cyberangel4869/PortableBlueToothKeyBoard/README.md

# PortableBlueToothKeyBoard
基于ESP32S3的9键蓝牙键盘，有蓝牙和有线两种模式，可以从C口直接编程和供电，带有自动休眠功能，一段时间内无人使用就自动降低中断处理频率或进入休眠模式以节省电量。

立创开源硬件平台地址：

https://oshwhub.com/elecangel/project_krufaupn

## 外观
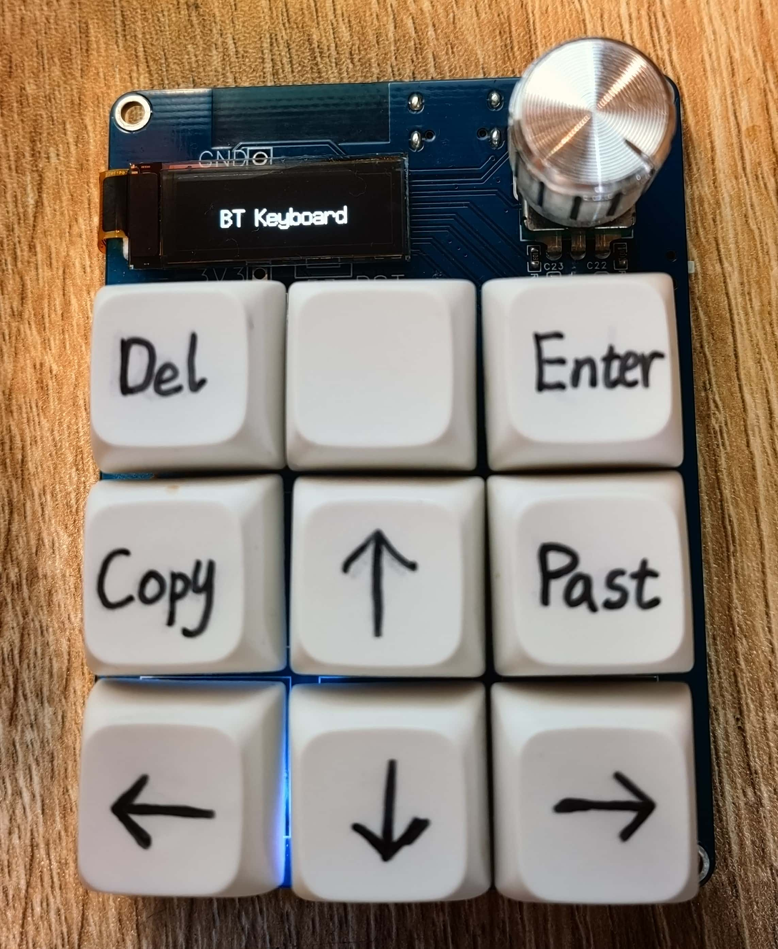
[picture p1: outlook.jpg]
outlook


## 硬件框架
**ESP32S3模组**
* 提供蓝牙连接核心功能
* 通过通用GPIO连接键盘阵列和旋转编码器

**锂电池充放电管理电路**
* TP4056锂电池充电芯片
* 电源自动切换电路
  * AO3415 PMOS
  * SS14低压降二极管
 
**LDO线性稳压电路**
* XC6219B332MR 3.3V线性降压芯片，压降低可兼容锂电池电压

**青轴按键阵列**
* 10K上拉电阻与100nF消抖电容
* 时间常数t=1ms，可有效抑制按键产生的高频抖动，同时又不至于让按键弹起的上升沿过慢提高按键延迟

**旋转式编码器**
* 通过AB两相下降沿的先后判断正反转
* 10K上拉与100nF消抖电容，有效消减触点抖动

**OLED显示屏**
* 1uF升压电容
* 4.7K I2C通讯协议上拉电阻

**RGB键盘灯**
* WS2812C 单线通讯

## 软件框架
```cpp
platformio.ini        //PlatformIO配置文件

src/main.cpp          //初始化代码，主循环
src/Encoder.h         //编码器类，包含配置函数与中断处理函数
src/KeyBoard.h        //按键类，含有配置函数和中断处理函数，其中中断处理函数返回按下按键键码的指针
src/OLED_Driver.h     //OLED显示类，基于U8G2库，对库函数进行再次封装，便于调用
src/WS2812Driver.h    //RGB灯带驱动库
```
## 电路与PCB设计
#### 电路原理图
```cpp
BTkeyboard_Schematic.pdf
```
#### 电路PCB设计
参见本目录下的`16键自定义键盘.epro`与`16键自定义键盘.epro2`
* 用嘉立创专业版打开`.epro`和`.epro2`文件，‘2’表示不同版本的嘉立创专业版
* 更多硬件设计与组装细节参见立创开源平台https://oshwhub.com/elecangel/project_krufaupn

## 功能更新
* 2026.10.7 新增了读写片上flash的功能，支持记录多组按键布局配置数据，后续将更新利用WebUI自定义按键布局的功能
