cyberangel4869/PortableBlueToothKeyBoard/BTkeyboard_Schematic.pdf

# IO20 14 IO³ 15

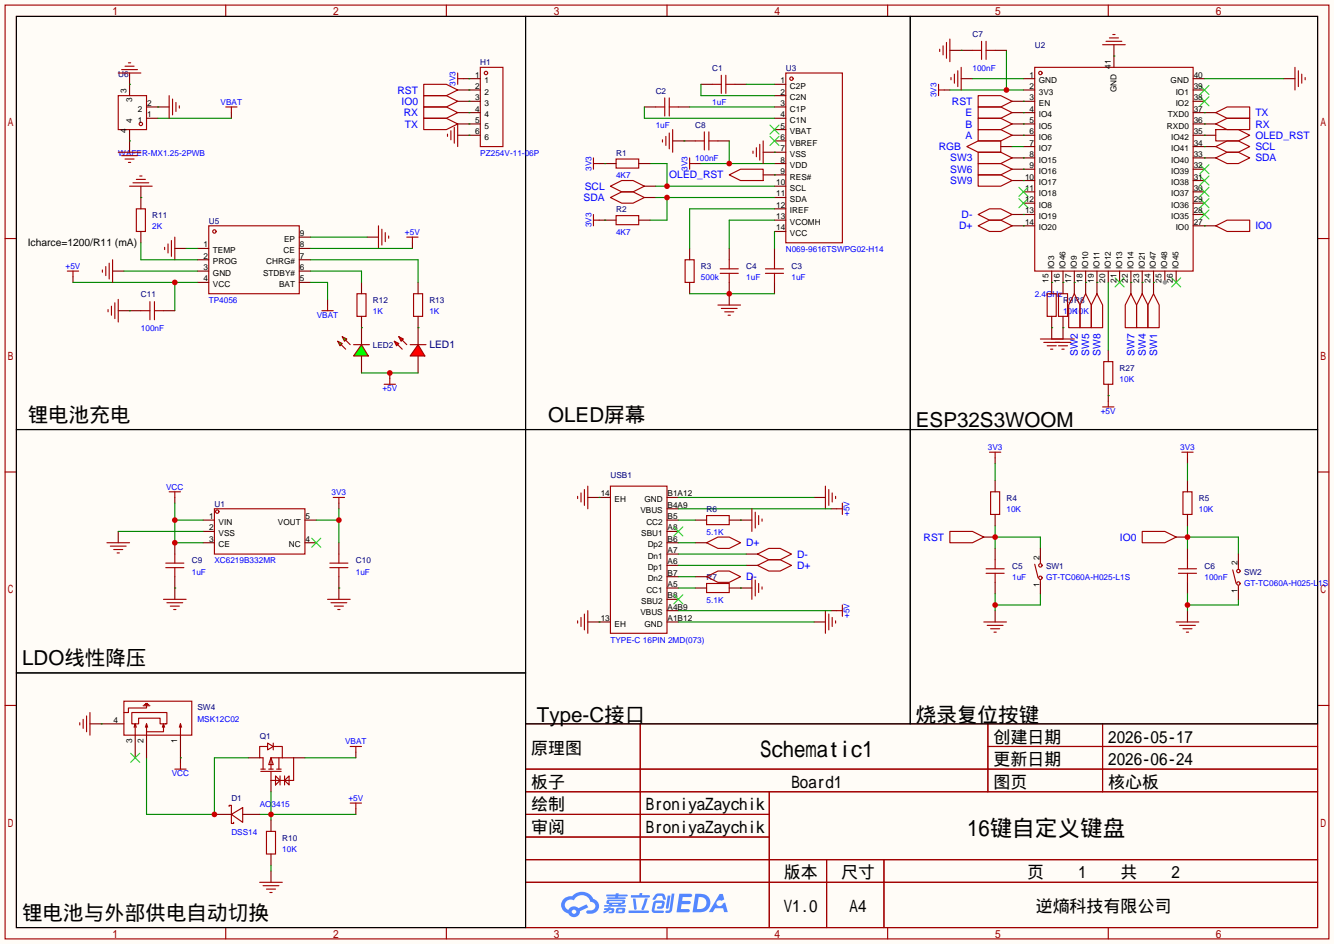
[picture p2: page 1]

USB1
GND A1B12 VBUS A4B9 SBU2 B8 CC1 A5 Dn2 B7 Dp1 A6 Dn1 A7 Dp2 B6 SBU1 A8 CC2 B5 VBUS B4A9 GND B1A12 EH 14

原理图 | Schematic1 | 创建日期 | 2026-05-17

更新日期 | 2026-06-24

板子 | Board1 | 图页 | 核心板
绘制 | BroniyaZaychik | 16键自定义键盘
审阅 | BroniyaZaychik

V1.0 | A4 | 逆熵科技有限公司

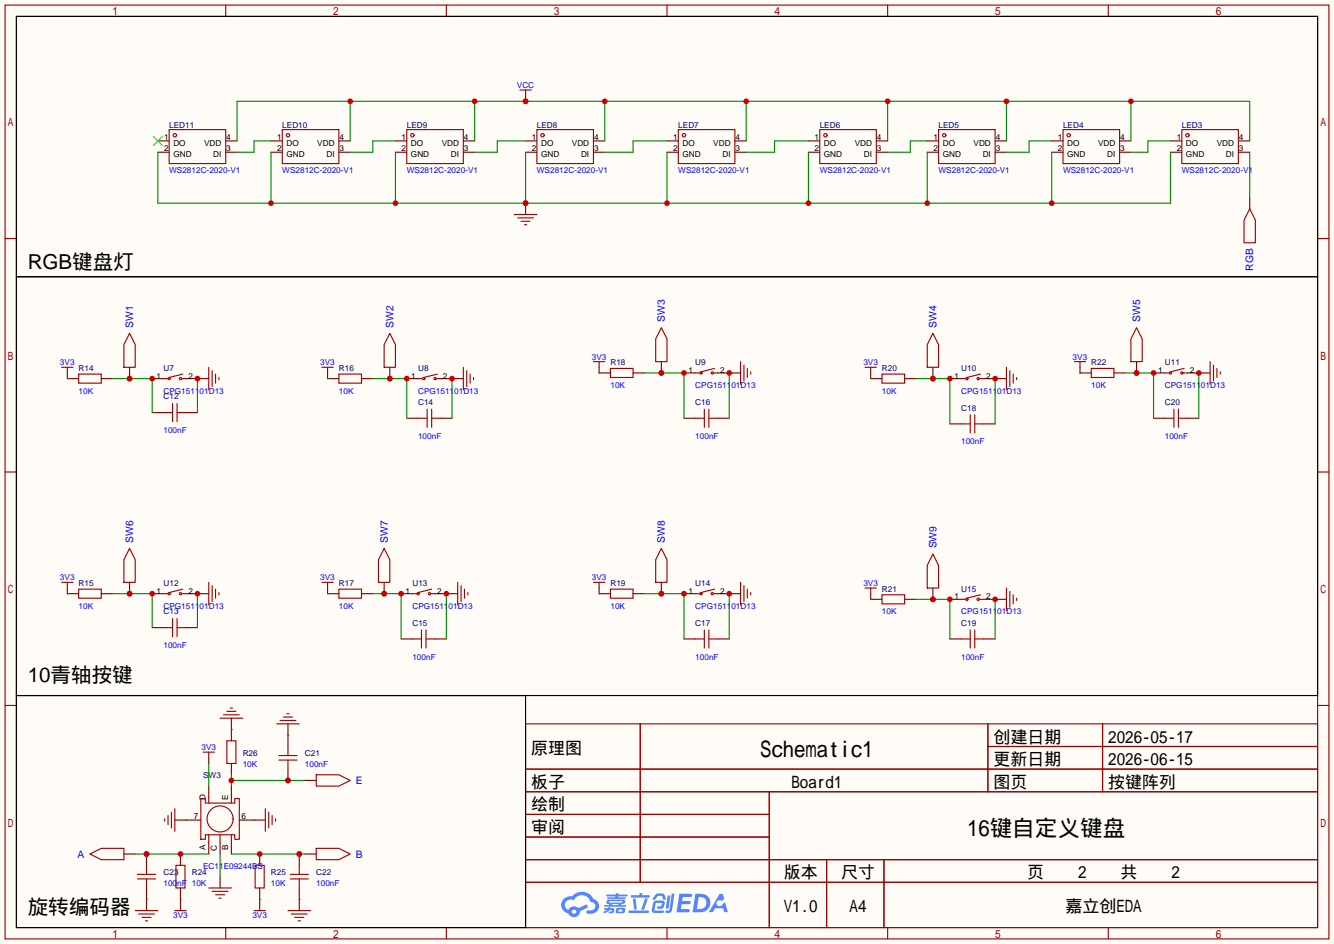
[picture p3: page 2]

原理图 | Schematic1 | 创建日期 | 2026-05-17

更新日期 | 2026-06-15

板子 | Board1 | 图页 | 按键阵列
绘制 | | 16键自定义键盘
审阅

V1.0 | A4 | 嘉立创EDA
