cyberangel4869/PortableBlueToothKeyBoard/(list of files, drawings)

Other design files:
9键自定义键盘.epro
